anton-mir/airc-device/enclosure_drawings/readme.md

### Autocad AirC device enclosure drawings

Use AutoCad 2000 to open
