anton-mir/airc-device/docs/AirC sensors and pinout specification.ods

DESCRIPTION | Range and max value | SENSOR Note | INFO
CO, digital | 1000 ppm, 1163 mg | spec | https://www.spec-sensors.com/product/digital-co-sensor/
NO2, digital | 5 ppm, 10 mg | spec | https://www.spec-sensors.com/product/digital-gas-sensor-module-no2/
SO2, digital | 20 ppm, 53 mg | spec | https://www.spec-sensors.com/product/digital-gas-sensor-module-so2/
O3, digital | 5 ppm, 1 mg | spec | https://www.spec-sensors.com/product/digital-gas-sensor-ozone/
Dust sensor PM2.5 and PM10 | 1.0-2.5 um, 2.5-10 um | NOVA SDS011 | https://www-sd-nf.oss-cn-beijing.aliyuncs.com/%E5%AE%98%E7%BD%91%E4%B8%8B%E8%BD%BD/SDS011%20laser%20PM2.5%20sensor%20specification-V1.4.pdf
CCS811 Air Quality Sensor | eCO2 (equivalent CO2) 0-5000 ppm TVOC (Total Volatile Organic Compounds) 0-6000 ppb | CCS811, I2C address 0x5A | https://www.dfrobot.com/product-1981.html
Complex HCHO sensor - CH3, C6H6, H2CO | 1-50 ppm | DFRobot Gravity HCHO Sensor | https://wiki.dfrobot.com/Gravity__HCHO_Sensor_SKU__SEN0231#target_4
Weather module | Temp: -40 - 85 Celsius with accuracy 0.5-1 degree Humidity: 0 - 100% | BME280, SDO->GND I2C address is 0x76 | https://cdn-shop.adafruit.com/datasheets/BST-BME280_DS001-10.pdf
Commuter CD74HC4067 |  |  | http://www.ti.com/lit/ds/symlink/cd74hc4067.pdf
STM32F104 DISCOVERY | Connection name | Note | Pinout at GL Board (number of pins/pin id)
PA8 | Commuter EN - Enable/Disable pin | MCO | 1xC
PE6 | Commuter CD74HC4067 control pin S0 | TP3 | 3xA
PC13 | Commuter CD74HC4067 control pin S1 | TP4 | 3xA
PE5 | Commuter CD74HC4067 control pin S2 | TP6 | 3xA
PD6 | Commuter CD74HC4067 control pin S3 | TP7 | 3xB
PD8 | Commuter CD74HC4067 output pin SIG | UART input/output duplex mode: huart3.Init.Mode = UART_MODE_TX_RX; | 3xG
PB6 | I2C SCL CCS811 Air Quality Sensor, BME280 |  | DD
PB9 | I2C SDA CCS811 Air Quality Sensor, BME280 |  | DD
PD2 | G led | TP9 | 3xB
PB14 | B led | TP10 | 2xF
PD3 | R led | TP8 | 3xB
PB15 | REED SW | TP11 | 2xF
PC6 | Connected to TX of ESP01 |  | EE
PC7 | Connected to RX of ESP01 |  | EE
PE1 | ESP01 Reset pin |  | EE
PC2 | Fan 1 | TP2 | 1xH
PA3 | Fan 2 | TP5 | 1xI
PD7 | SPI for Starterkit Flash memory CS pin
PA5 | SPI SCK
PB5 | SPI MOSI
PB4 | SPI MISO
PB1 | ADC for analog temp sensor on GL starterkit board
Commuter CD74HC4067 output pin name | Sensor | Comment | Note
C0 | HCHO sensor input | connected to TX pin of HCHO sensor | Sends data periodically always
C1 | input from PM dust sensor | connected to TX pin of dust sensor | Sends data periodically after initial setup
C2 | SO2 spec sensor input | RX pin of spec sensor | get data from sensor
C3 | SO2 spec sensor output | TX pin of spec sensor | send to sensor
C4 | NO2 spec sensor input | RX pin of spec sensor | get data from sensor
C5 | NO2 spec sensor output | TX pin of spec sensor | send to sensor
C6 | CO spec sensor input | RX pin of spec sensor | get data from sensor
C7 | CO spec sensor output | TX pin of spec sensor | send to sensor
C8 | O3 spec sensor input | RX pin of spec sensor | get data from sensor
C9 | O3 spec sensor output | TX pin of spec sensor | send to sensor
C10 | output commands to PM dust sensor | connected to RX pin of dust sensor | TODO: add code for sending commands
