anton-mir/airc-device/pcb/3D View SIde A.png

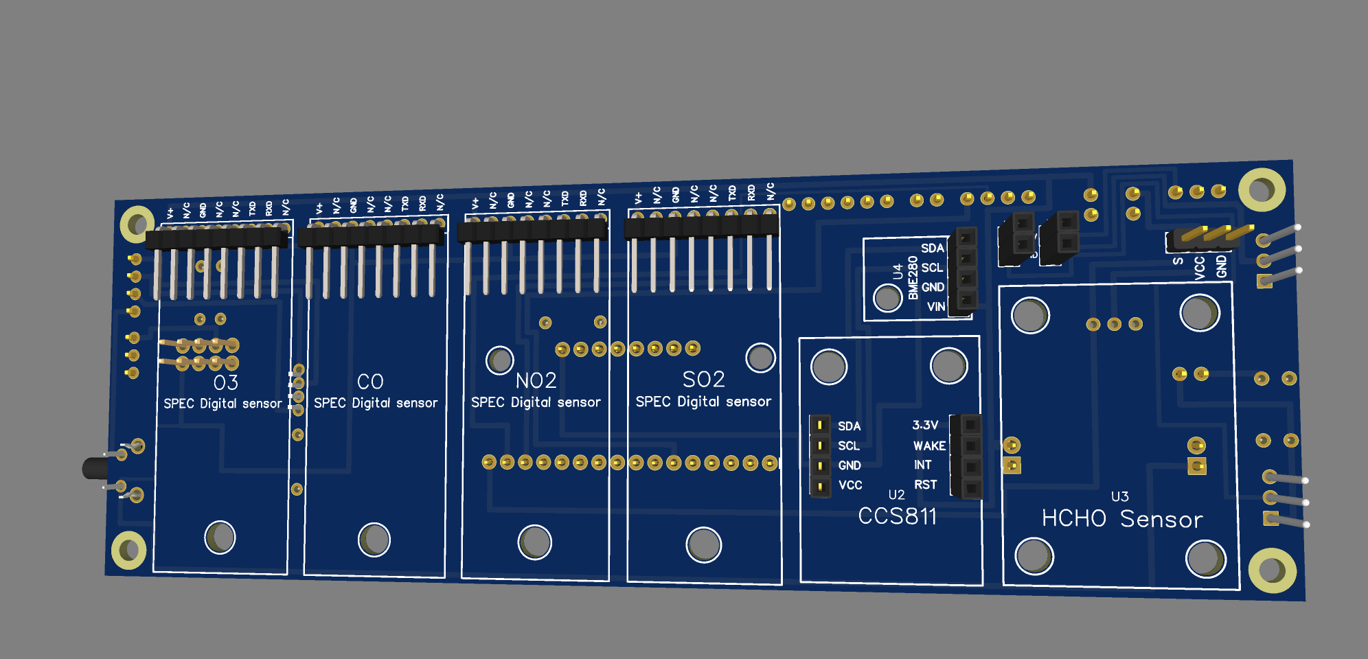
pcb/3D View SIde A.png
