anton-mir/airc-device/pcb/3D View Side B.png

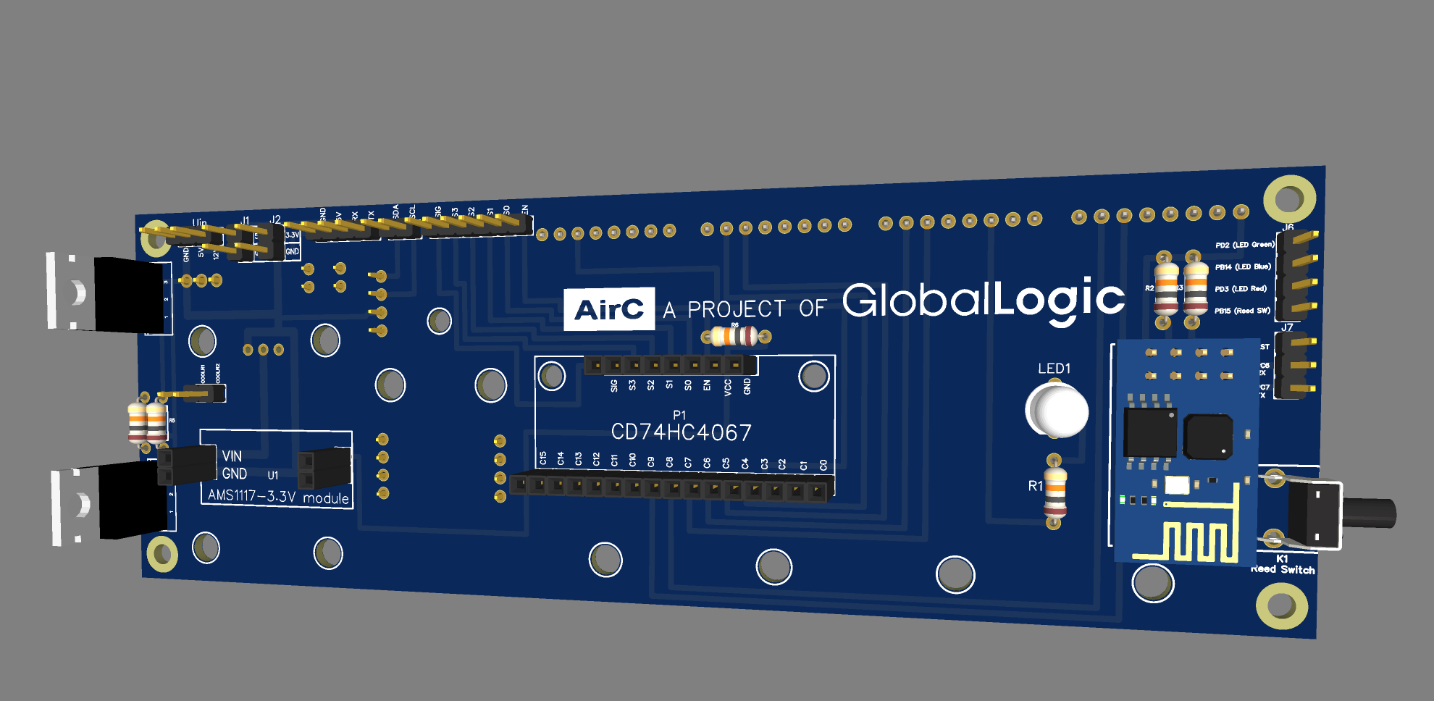
pcb/3D View Side B.png
