anton-mir/airc-device/pcb/Side A.png

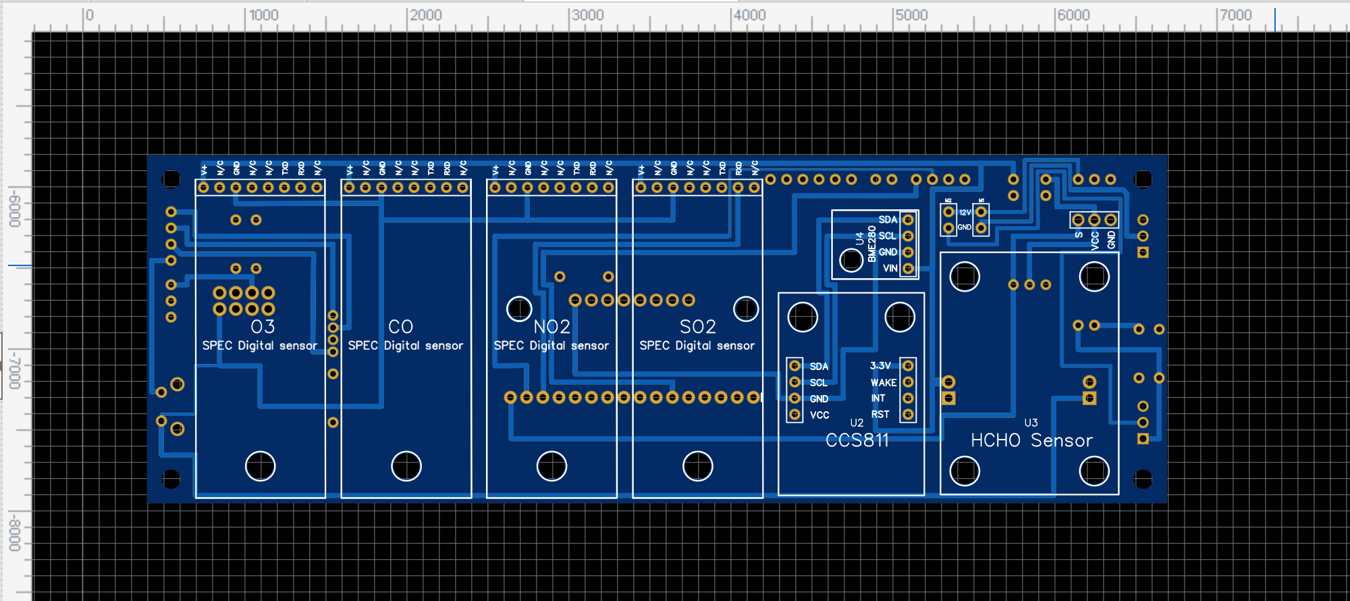
pcb/Side A.png
