anton-mir/airc-device/pcb/Side B.png

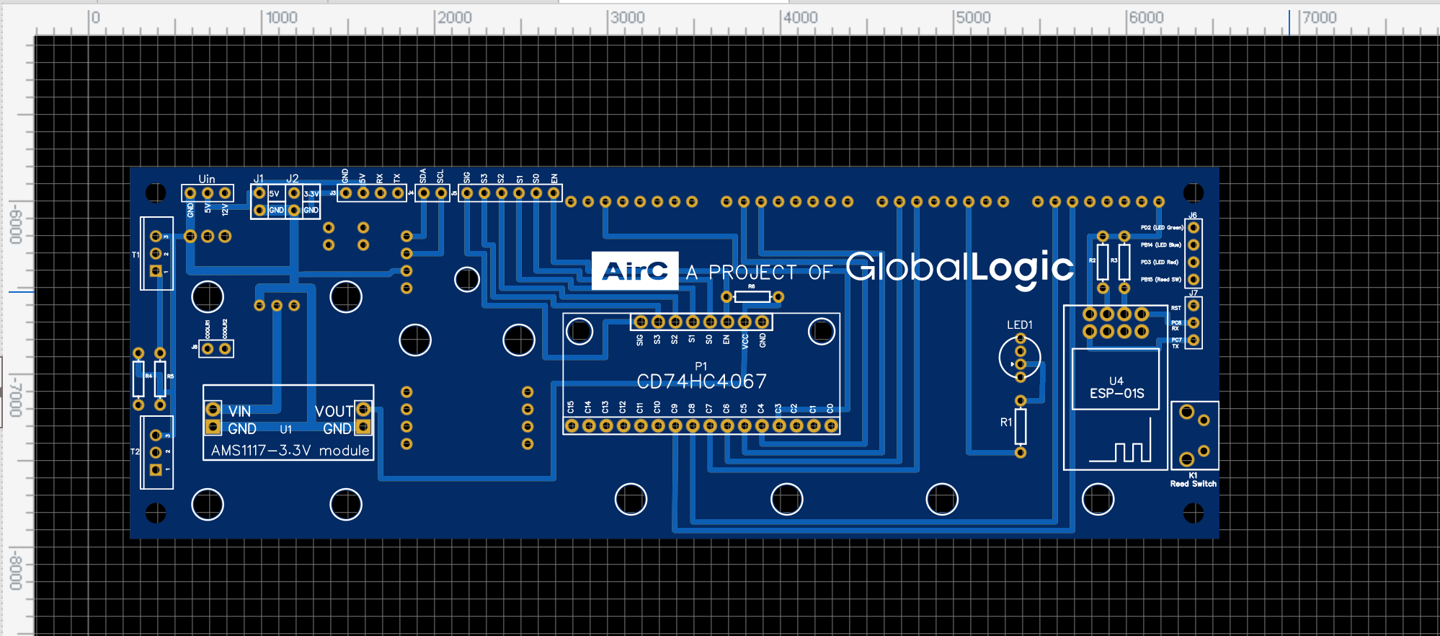
pcb/Side B.png
