anton-mir/airc-device/docs/SEN0231 HCHO Sensor Schematic.pdf

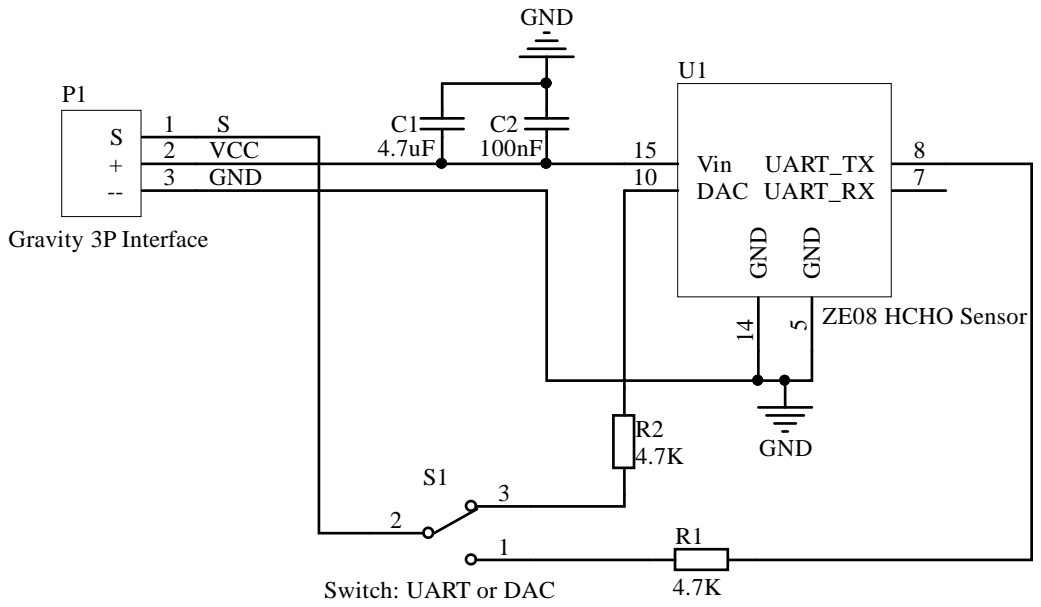
[picture p5: page 1]

Switch: UART or DAC

HCHO Sensor Title: | SKU: SEN0231
Drawn: roker-CD | Revision: V1.0 | Size: A4

Date: 2016/12/9 | Time: 18:14:12
