anton-mir/airc-device/pcb/Schematic.pdf

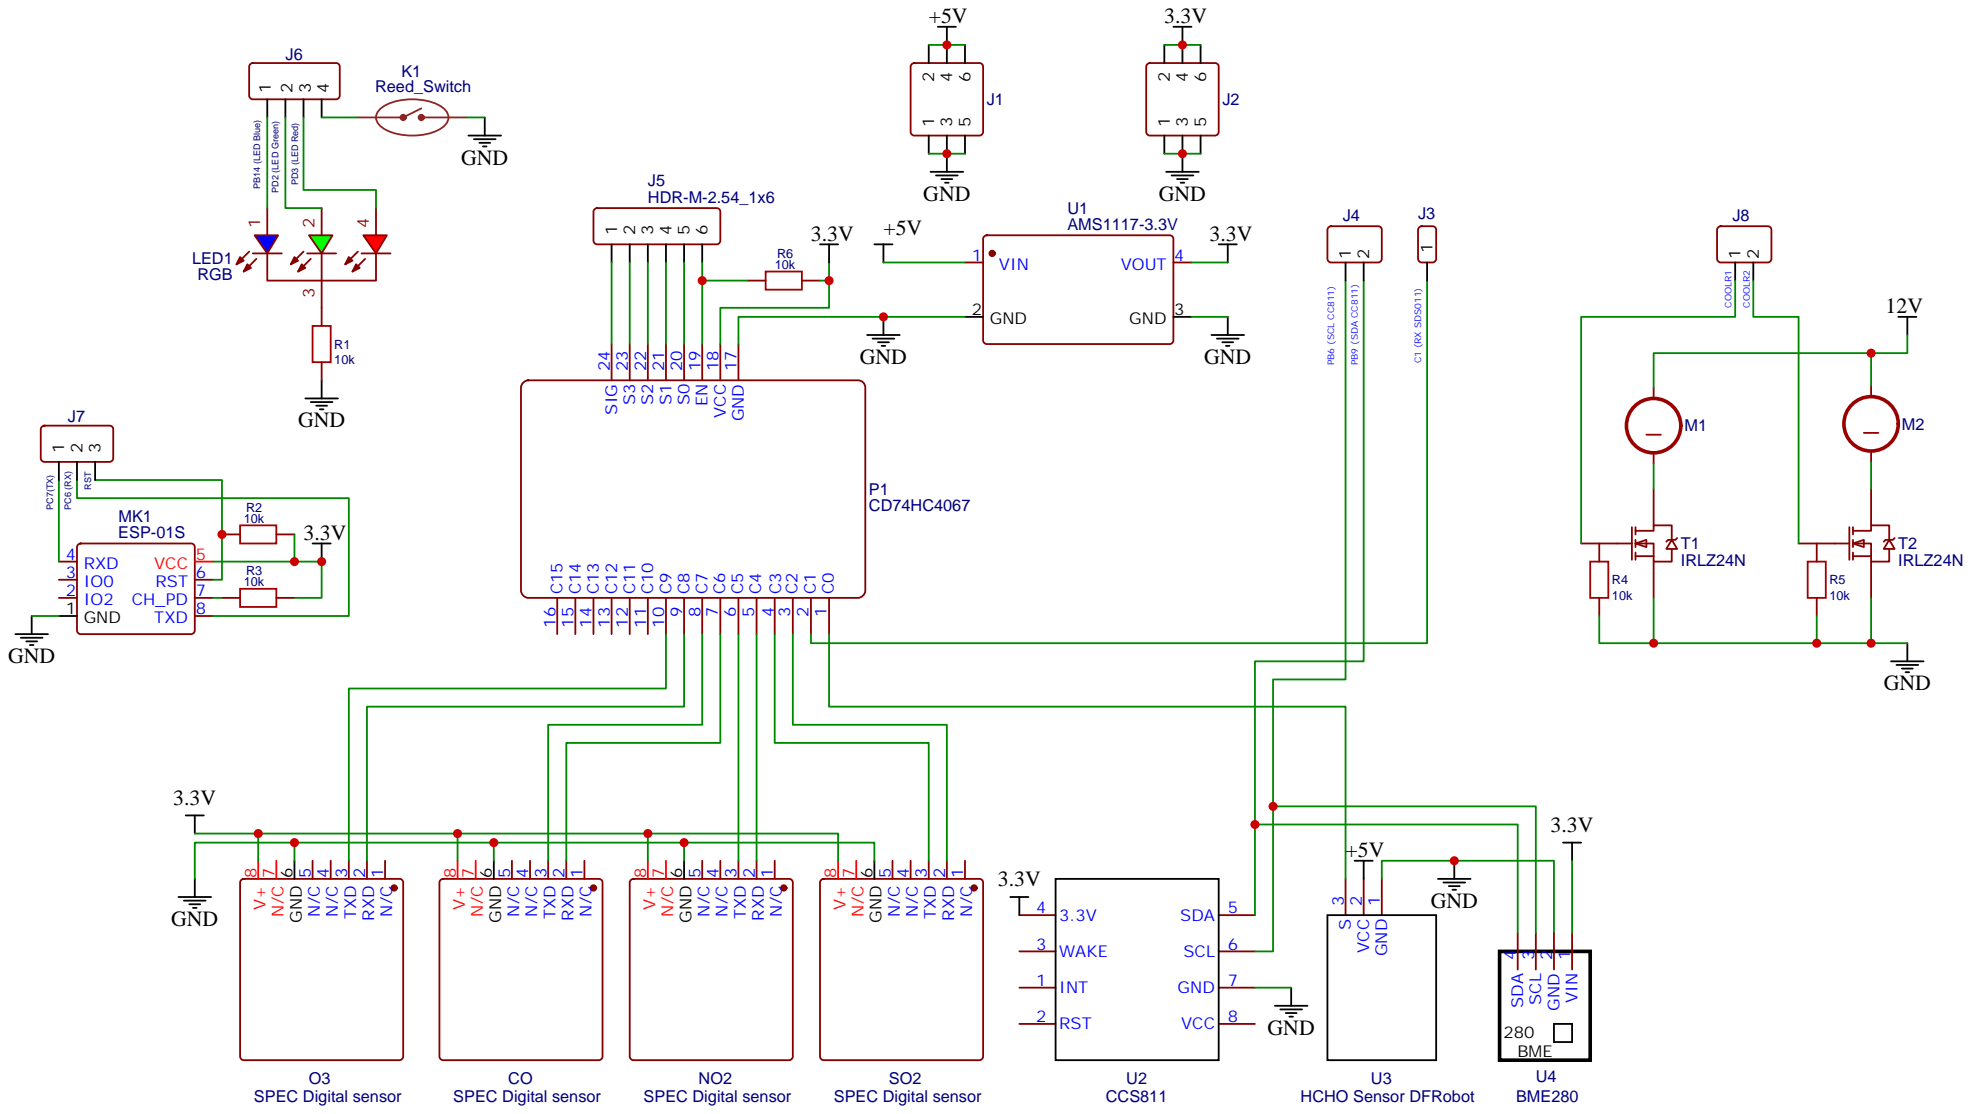
[picture p6: page 1]

GND 17 VCC 18 EN 19 S0 20 S1 21 S2 22 S3 23 SIG 24
