anton-mir/airc-device/pcb/Side A-B.pdf

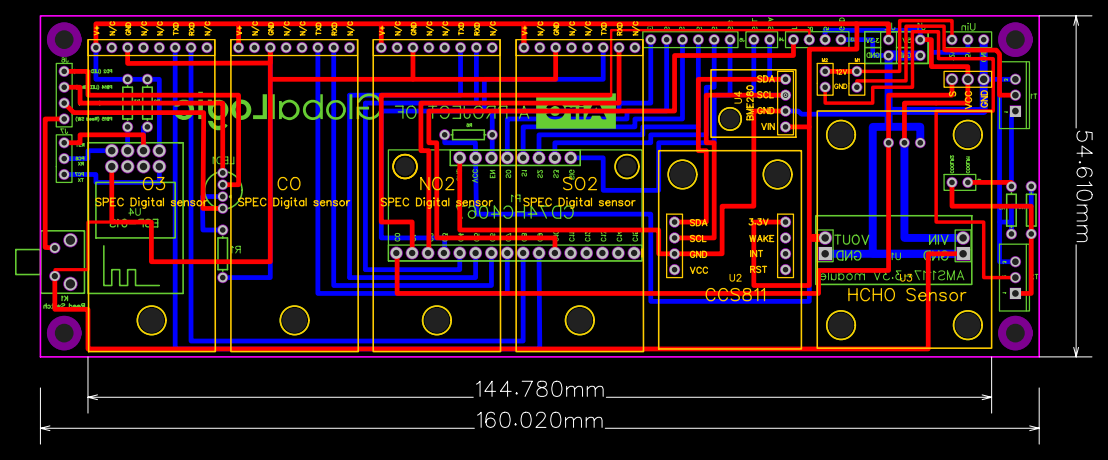
[picture p7: page 1]
