anton-mir/airc-device/pcb/Side A.pdf

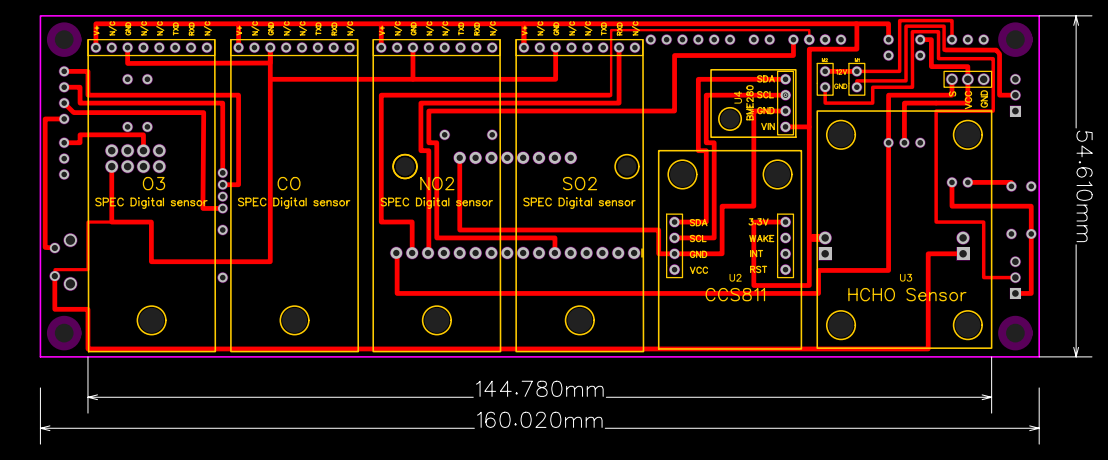
[picture p8: page 1]
