anton-mir/airc-device/pcb/Side B.pdf

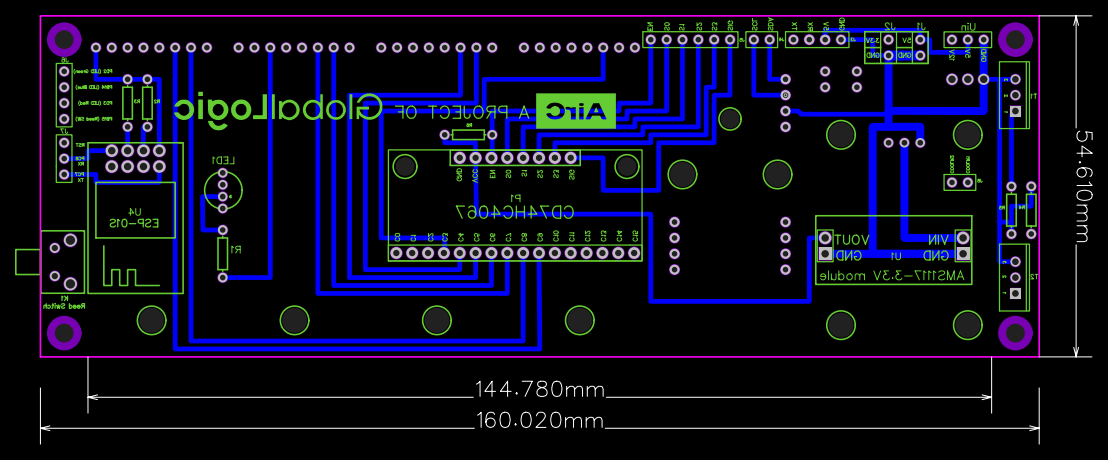
[picture p9: page 1]
