anton-mir/airc-device/src/main.c

/**
  ******************************************************************************
  * @file    Templates/Src/main.c
  * @author  MCD Application Team
  * @brief   Main program body
  ******************************************************************************
  * @attention
  *
  * <h2><center>&copy; COPYRIGHT(c) 2017 STMicroelectronics</center></h2>
  *
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
  ******************************************************************************
  */

/* Includes ------------------------------------------------------------------*/
#include "main.h"
#include "lwip/init.h"
#include "lwip/netif.h"
#include "lwip/timeouts.h"
#include "lwip/inet.h"
#include "lwip/tcpip.h"
#include "netif/etharp.h"
#include "ethernetif.h"
#include "uart_sensors.h"
#include "esp8266_wifi.h"
#include "http_helper.h"
#include "ksz8081rnd.h"
#include "wh1602.h"
#include "FreeRTOS.h"
#include "FreeRTOSConfig.h"
#include "task.h"
#include "tasks_def.h"
#include "hw_delay.h"
#include "lm335z.h"
#include "eth_server.h"
#include "eth_sender.h"
#include "queue.h"
#include "i2c_ccs811sensor.h"
#include "data_collector.h"
#include "leds.h"
#include "flash_SST25VF016B.h"
#include "config_board.h"
#include"fans.h"
#include "display_data.h"
#include "bmp280.h"

volatile boxConfig_S device_config = { 0 };

TaskHandle_t init_handle = NULL;
TaskHandle_t ethif_in_handle = NULL;
TaskHandle_t link_state_handle = NULL;
TaskHandle_t dhcp_fsm_handle = NULL;
TaskHandle_t wifi_tsk_handle = NULL;
TaskHandle_t esp_rx_tsk_handle = NULL;
TaskHandle_t analog_temp_handle = NULL;
TaskHandle_t eth_server_handle = NULL;
TaskHandle_t i2c_ccs811sensor_handle = NULL;
TaskHandle_t eth_sender_handle = NULL;
TaskHandle_t data_collector_handle = NULL;
TaskHandle_t reed_switch_handle = NULL;
TaskHandle_t uart_sensors_handle = NULL;
TaskHandle_t display_data_task_handle = NULL;
TaskHandle_t i2c_bme280_sensor_handle = NULL;

EventGroupHandle_t eg_task_started = NULL;

static RNG_HandleTypeDef rng_handle;

struct netif gnetif;

static void SystemClock_Config(void);
void Error_Handler(void);
static void netif_setup();
void init_task(void *arg);

uint32_t rand_wrapper()
{
    uint32_t random = 0;
    (void)HAL_RNG_GenerateRandomNumber(&rng_handle, &random);

    return random;
}

void init_task(void *arg)
{
    GPIO_InitTypeDef gpio;
    BaseType_t status;
    struct netif *netif = (struct netif *)arg;

    __HAL_RCC_GPIOD_CLK_ENABLE();
    __HAL_RCC_GPIOC_CLK_ENABLE();
    __HAL_RCC_USART6_CLK_ENABLE();
    __HAL_RCC_DMA2_CLK_ENABLE();

    (void)HAL_RNG_Init(&rng_handle);

    eg_task_started = xEventGroupCreate();
    configASSERT(eg_task_started);

    xEventGroupSetBits(eg_task_started, EG_INIT_STARTED);
    initBlueButtonAndReedSwitch();
    initLeds();
    init_fans();

    /* Initialize LCD */
    lcd_init();
    lcd_clear();
    lcd_print_string("Init...");

    // Init ESP8266
    ESP_InitPins();
    ESP_InitUART();
    ESP_InitDMA();

    //Init Flash_SPI
    Flash_Init();

    /* Create TCP/IP stack thread */
    tcpip_init(NULL, NULL);

    /* Initialize PHY */
    netif_setup();
    status = xTaskCreate(
            link_state,
            "link_st",
            LINK_STATE_TASK_STACK_SIZE,
            (void *) netif,
            LINK_STATE_TASK_PRIO,
            &link_state_handle);

    configASSERT(status);

    status = xTaskCreate(
            dhcp_fsm,
            "dhcp_fsm",
            DHCP_FSM_TASK_STACK_SIZE,
            (void *) netif,
            DHCP_FSM_TASK_PRIO,
            &dhcp_fsm_handle);

    configASSERT(status);

    status = xTaskCreate(
            ethernetif_input,
            "ethif_in",
            ETHIF_IN_TASK_STACK_SIZE,
            (void *) netif,
            ETHIF_IN_TASK_PRIO,
            &ethif_in_handle);

    configASSERT(status);

    status = xTaskCreate(
            uart_sensors,
            "uart_sensors",
            UART_SENSORS_TASK_STACK_SIZE,
            (void *)netif,
            UART_SENSORS_TASK_PRIO,
            &uart_sensors_handle);

    configASSERT(status);

    status = xTaskCreate(
            bme280_sensor,
            "i2c_bme280_sensor",
            I2C_BME280_SENSOR_TASK_STACK_SIZE,
            (void *)netif,
            I2C_BME280_SENSOR_TASK_PRIO,
            &i2c_bme280_sensor_handle);

    configASSERT(status);

    status = xTaskCreate(
            eth_server,
            "eth_server",
            ETH_SERVER_TASK_STACK_SIZE,
            NULL,
            ETH_SERVER_TASK_PRIO,
            &eth_server_handle);

    configASSERT(status);

    status = xTaskCreate(
	     i2c_ccs811sensor,
 	     "i2c_ccs811sensor",
             ETH_SERVER_TASK_STACK_SIZE,
             NULL,
             ETH_SERVER_TASK_PRIO,
             &i2c_ccs811sensor_handle);

    configASSERT(status);

    status = xTaskCreate(
                esp_rx_task,
                "esp_rx_tsk",
                ESP8266_RX_TASK_STACK_SIZE,
                NULL,
                ESP8266_RX_TASK_PRIO,
                &esp_rx_tsk_handle);

    configASSERT(status);

    status = xTaskCreate(
                wifi_task,
                "wifi_tsk",
                ESP8266_WIFI_TASK_STACK_SIZE,
                NULL,
                ESP8266_WIFI_TASK_PRIO,
                &wifi_tsk_handle);

    configASSERT(status);

    status = xTaskCreate(
            analog_temp,
            "analog_temp",
            ANALOG_TEMP_TASK_STACK_SIZE,
            NULL,
            ANALOG_TEMP_TASK_PRIO,
            &analog_temp_handle);

    configASSERT(status);

    status = xTaskCreate(
            data_collector,
            "data_collector",
            DATA_COLLECTOR_STACK_SIZE,
            NULL,
            DATA_COLLECTOR_PRIO,
            &data_collector_handle);
    configASSERT(status);

    status = xTaskCreate(
            eth_sender,
            "eth_sender",
            ETH_SENDER_TASK_STACK_SIZE,
            NULL,
            ETHIF_IN_TASK_PRIO,
            &eth_sender_handle);

    configASSERT(status);

    status = xTaskCreate(
            reed_switch_task,
            "reed_switch_task",
            REED_SWITCH_STACK_SIZE,
            NULL,
            REED_SWITCH_PRIO,
            &reed_switch_handle);
    configASSERT(status);
    status = xTaskCreate(
        display_data_task,
        "displya_data_task",
        DISPLAY_DATA_TASK_STACK_SIZE,
        NULL,
        DISPLAY_DATA_TASK_PRIO,
        &display_data_task_handle);
    configASSERT(status);

    /* Wait for all tasks initialization */
    xEventGroupWaitBits(
            eg_task_started,
            (EG_INIT_STARTED | EG_ETHERIF_IN_STARTED | EG_LINK_STATE_STARTED |
             EG_DHCP_FSM_STARTED | EG_UART_SENSORS_STARTED | EG_WIFI_TSK_STARTED |
             EG_ESP_RX_TSK_STARTED | EG_ANALOG_TEMP_STARTED | EG_ETH_SENDER_STARTED |
             EG_ETH_SERVER_STARTED | EG_DATA_COLLECTOR_STARTED| EG_REED_SWITCH_STARTED |
             EG_I2C_BME280_STARTED | EG_I2C_CCS811_STARTED),
            pdFALSE,
            pdTRUE,
            portMAX_DELAY);

    if (netif_is_up(netif)) {
        /* Start DHCP address request */
        ethernetif_dhcp_start();
    }


    gpio.Mode = GPIO_MODE_OUTPUT_PP;
    gpio.Pull = GPIO_NOPULL;
    gpio.Pin = GPIO_PIN_13;
    HAL_GPIO_Init(GPIOD, &gpio);
    HAL_GPIO_WritePin(GPIOD, GPIO_PIN_13, GPIO_PIN_SET);

    // Multiplexer on/off pin - init to off state (pull-up)
    gpio.Mode = GPIO_MODE_OUTPUT_PP;
    gpio.Pull = GPIO_PULLUP;
    gpio.Pin = GPIO_PIN_8;
    HAL_GPIO_Init(GPIOA, &gpio);
    HAL_GPIO_WritePin(GPIOA, GPIO_PIN_8, GPIO_PIN_SET);

    for (;;) {

        uint16_t current_pin = choose_pin(current_mode);
        static uint8_t leds_turned_off = 0;

//        if (!netif_is_link_up(netif)) {
//            lcd_clear();
//            lcd_print_string_at("Link:", 0, 0);
//            lcd_print_string_at("down", 0, 1);
//        }

        if (current_pin == OFF_LEDS)
        {
            if (!leds_turned_off) // Don't reset leds if they are already reset
            {
                HAL_GPIO_WritePin(GPIOD,RED_LED |GREEN_LED,GPIO_PIN_RESET);
                HAL_GPIO_WritePin(GPIOB,BLUE_LED,GPIO_PIN_RESET);
                leds_turned_off = 1;
            }
        }
        else
        {
            leds_turned_off = 0;
            TickType_t delay = (current_pin == RED_LED) ? 500u : 1500u;
            if (current_pin == BLUE_LED)
            {
                HAL_GPIO_TogglePin(GPIOB,current_pin);
            }
            else
            {
                HAL_GPIO_TogglePin(GPIOD,current_pin);
            }
            vTaskDelay(delay);
        }
    }
}
/* Private functions ---------------------------------------------------------*/
/**
  * @brief  Main program
  * @param  None
  * @retval None
  */
int main(void)
{
    BaseType_t status;

    HAL_Init();

    /* Configure the system clock to 168 MHz */
    SystemClock_Config();

    status = xTaskCreate(
                    init_task,
                    "init",
                    INIT_TASK_STACK_SIZE,
                    (void *)&gnetif,
                    INIT_TASK_PRIO,
                    &init_handle);

    configASSERT(status);

    vTaskStartScheduler();

    for (;;) { ; }
}

void HAL_MspInit(void)
{
    __HAL_RCC_SYSCFG_CLK_ENABLE();
    __HAL_RCC_PWR_CLK_ENABLE();
}

uint32_t HAL_GetTick(void)
{
    return xTaskGetTickCount();
}

void HAL_I2C_MspInit(I2C_HandleTypeDef* hi2c)
{
    GPIO_InitTypeDef GPIO_InitStruct = {0};
    if (hi2c->Instance == I2C1) {
        __HAL_RCC_GPIOB_CLK_ENABLE();

        /**I2C1 GPIO Configuration
        PB6     ------> I2C1_SCL
        PB9     ------> I2C1_SDA
        */
        GPIO_InitStruct.Pin = GPIO_PIN_6 | GPIO_PIN_9;
        GPIO_InitStruct.Mode = GPIO_MODE_AF_OD;
        GPIO_InitStruct.Pull = GPIO_PULLUP;
        GPIO_InitStruct.Speed = GPIO_SPEED_FREQ_VERY_HIGH;
        GPIO_InitStruct.Alternate = GPIO_AF4_I2C1;
        HAL_GPIO_Init(GPIOB, &GPIO_InitStruct);

        __HAL_RCC_I2C1_CLK_ENABLE();
    }
}

/**
  * @brief  System Clock Configuration
  *         The system Clock is configured as follow :
  *            System Clock source            = PLL (HSE)
  *            SYSCLK(Hz)                     = 168000000
  *            HCLK(Hz)                       = 168000000
  *            AHB Prescaler                  = 1
  *            APB1 Prescaler                 = 4
  *            APB2 Prescaler                 = 2
  *            HSE Frequency(Hz)              = 8000000
  *            PLL_M                          = 8
  *            PLL_N                          = 336
  *            PLL_P                          = 2
  *            PLL_Q                          = 7
  *            VDD(V)                         = 3.3
  *            Main regulator output voltage  = Scale1 mode
  *            Flash Latency(WS)              = 5
  * @param  None
  * @retval None
  */
static void SystemClock_Config(void)
{
    RCC_ClkInitTypeDef RCC_ClkInitStruct;
    RCC_OscInitTypeDef RCC_OscInitStruct;

    /* Enable Power Control clock */
    __HAL_RCC_PWR_CLK_ENABLE();

    /* The voltage scaling allows optimizing the power consumption when the device is
        clocked below the maximum system frequency, to update the voltage scaling value
        regarding system frequency refer to product datasheet.  */
    __HAL_PWR_VOLTAGESCALING_CONFIG(PWR_REGULATOR_VOLTAGE_SCALE1);

    /* Enable HSE Oscillator and activate PLL with HSE as source */
    RCC_OscInitStruct.OscillatorType = RCC_OSCILLATORTYPE_HSE;
    RCC_OscInitStruct.HSEState = RCC_HSE_ON;
    RCC_OscInitStruct.PLL.PLLState = RCC_PLL_ON;
    RCC_OscInitStruct.PLL.PLLSource = RCC_PLLSOURCE_HSE;
    RCC_OscInitStruct.PLL.PLLM = 8;
    RCC_OscInitStruct.PLL.PLLN = 336;
    RCC_OscInitStruct.PLL.PLLP = RCC_PLLP_DIV2;
    RCC_OscInitStruct.PLL.PLLQ = 7;
    if(HAL_RCC_OscConfig(&RCC_OscInitStruct) != HAL_OK)
    {
        /* Initialization Error */
        Error_Handler();
    }

    /* Select PLL as system clock source and configure the HCLK, PCLK1 and PCLK2
        clocks dividers */
    RCC_ClkInitStruct.ClockType = (RCC_CLOCKTYPE_SYSCLK | RCC_CLOCKTYPE_HCLK | RCC_CLOCKTYPE_PCLK1 | RCC_CLOCKTYPE_PCLK2);
    RCC_ClkInitStruct.SYSCLKSource = RCC_SYSCLKSOURCE_PLLCLK;
    RCC_ClkInitStruct.AHBCLKDivider = RCC_SYSCLK_DIV1;
    RCC_ClkInitStruct.APB1CLKDivider = RCC_HCLK_DIV4;
    RCC_ClkInitStruct.APB2CLKDivider = RCC_HCLK_DIV2;
    if(HAL_RCC_ClockConfig(&RCC_ClkInitStruct, FLASH_LATENCY_5) != HAL_OK)
    {
        /* Initialization Error */
        Error_Handler();
    }

    /* STM32F405x/407x/415x/417x Revision Z devices: prefetch is supported  */
    if (HAL_GetREVID() == 0x1001)
    {
        /* Enable the Flash prefetch */
        __HAL_FLASH_PREFETCH_BUFFER_ENABLE();
    }
}

/**
  * @brief EXTI line detection callbacks
  * @param  pin: Specifies the pins connected EXTI line
  * @retval None
  */

void HAL_GPIO_EXTI_Callback(uint16_t pin)
{
    if (pin == BLUE_BUTTON_DISCOVERY)
    {
        HAL_GPIO_TogglePin(GPIOD, RED_LED_DISCOVERY);
    }
    else if (pin == RMII_PHY_INT_PIN)
    {
        /* Get the IT status register value */
        ethernetif_phy_irq();
    }
}

static void netif_setup()
{
    ip_addr_t ipaddr;
    ip_addr_t netmask;
    ip_addr_t gw;

    ip_addr_set_zero_ip4(&ipaddr);
    ip_addr_set_zero_ip4(&netmask);
    ip_addr_set_zero_ip4(&gw);

    /* Add the network interface */
    netif_add(&gnetif, &ipaddr, &netmask, &gw, NULL, &ethernetif_init, &ethernet_input);

    /* Registers the default network interface */
    netif_set_default(&gnetif);

    /* Set the link callback function, this function is called on change of link status */
    netif_set_link_callback(&gnetif, ethernetif_link_update);

    if (netif_is_link_up(&gnetif))
    {
        /* When the netif is fully configured this function must be called */
        netif_set_up(&gnetif);
    }
    else
    {
        /* When the netif link is down this function must be called */
        netif_set_down(&gnetif);
    }
}

/**
  * @brief  This function is executed in case of error occurrence.
  * @param  None
  * @retval None
  */
void Error_Handler(void)
{
    lcd_clear();
    lcd_print_string("Er@Error_Handler");
    HAL_Delay(1000);
    /* User may add here some code to deal with this error */
    while(1)
    {
    }
}

void EXTI0_IRQHandler(void){
    HAL_GPIO_EXTI_IRQHandler(BLUE_BUTTON_DISCOVERY);
}



void initLeds()
{
    __HAL_RCC_GPIOD_CLK_ENABLE();
    GPIO_InitTypeDef gpio;
    gpio.Mode = GPIO_MODE_OUTPUT_PP;
    gpio.Pull = GPIO_PULLUP;

    gpio.Pin = RED_LED | GREEN_LED;
    HAL_GPIO_Init(GPIOD, &gpio);
    HAL_GPIO_WritePin(GPIOD,RED_LED |GREEN_LED,GPIO_PIN_RESET);

    gpio.Pin = BLUE_LED;
    HAL_GPIO_Init(GPIOB, &gpio);
    HAL_GPIO_WritePin(GPIOB,BLUE_LED,GPIO_PIN_RESET);

    gpio.Pin = RED_LED_DISCOVERY;
    HAL_GPIO_Init(GPIOD, &gpio);
    HAL_GPIO_WritePin(GPIOD,RED_LED_DISCOVERY,GPIO_PIN_RESET);
}

/************************ (C) COPYRIGHT STMicroelectronics *****END OF FILE****/
