anton-mir/airc-device/src/uart_sensors.c

#include "uart_sensors.h"

#include <stdint.h>
#include <stdlib.h>
#include <ctype.h>
#include "FreeRTOS.h"
#include "task.h"
#include "main.h"
#include "string.h"
#include "semphr.h"

#define NOTIFY_CLEAR_VAL    (0xFFFFFFFF)
#define HAL_DEFAULT_TIMEOUT (500)
/* 5ms will be enough to send 1 byte */
#define WAKEUP_TIMEOUT      (5)
#define DATA_REQ_TIMEOUT    (5)

#define UART_DISABLE_RXTX(__HANDLE__)        \
  do{                                                       \
    CLEAR_BIT((__HANDLE__)->Instance->CR1, (USART_CR1_RE | USART_CR1_TE)); \
  } while(0U)

struct dma_base_reg {
  __IO uint32_t ISR;   /*!< DMA interrupt status register */
  __IO uint32_t Reserved0;
  __IO uint32_t IFCR;  /*!< DMA interrupt flag clear register */
};

uint8_t spec_wake = '\n';
uint8_t spec_get_data = '\r';
uint8_t spec_reset = 'r';
uint8_t spec_sleep = 's';
uint8_t spec_continuous = 'c';

SemaphoreHandle_t HCHO_mutex = NULL;
SemaphoreHandle_t PMS_mutex = NULL;
SemaphoreHandle_t SPEC_mutex = NULL;

xTimerHandle timer_SPEC_ISR;

volatile char uart3IncomingDataBuffer[MAX_SPEC_BUF_LEN];
double pm2_5_val = 0;
double pm10_val = 0;
double HCHO_val = 0;

struct SPEC_values SPEC_SO2_values, SPEC_NO2_values, SPEC_CO_values, SPEC_O3_values;

const long long int SPEC_SO2_SN = 102219020326;
const long long int SPEC_NO2_SN = 31120010317;
const long long int SPEC_CO_SN = 60619020451;
const long long int SPEC_O3_SN = 22620010208;

typedef enum{
    SPEC_T_SO2,
    SPEC_T_NO2,
    SPEC_T_CO,
    SPEC_T_O3
}SPEC_TYPES;

typedef enum{
    HCHO_T,
    PM10_T,
    PM2_5_T,
}PM_HCHO_TYPES;

static HAL_StatusTypeDef uart_spec_wakeup(uint8_t chan);
static HAL_StatusTypeDef uart_spec_get_data(uint8_t tx, uint8_t rx,
                                            uint32_t *rx_len);
static HAL_StatusTypeDef uart_enable_tx(uint8_t chan);
static HAL_StatusTypeDef uart_enable_rx(uint8_t chan, uint8_t *buf,
                                        uint32_t buf_len);
static HAL_StatusTypeDef uart_send_data(uint8_t *data, uint32_t len,
                                        uint32_t timeout);
static uint32_t uart_wait_response(uint32_t timeout);
static HAL_StatusTypeDef uart_release();
static HAL_StatusTypeDef uart_enable_dma_rx(UART_HandleTypeDef *huart,
                                            uint8_t *data, uint16_t size);
static HAL_StatusTypeDef uart_disable_dma_rx(UART_HandleTypeDef *huart);
static void uart_end_rx_transfer(UART_HandleTypeDef *huart);

static void USART3_UART_Init(void)
{
    huart3.Instance = USART3;
    huart3.Init.BaudRate = 9600;
    huart3.Init.WordLength = UART_WORDLENGTH_8B;
    huart3.Init.StopBits = UART_STOPBITS_1;
    huart3.Init.Parity = UART_PARITY_NONE;
    huart3.Init.Mode = UART_MODE_TX_RX;
    huart3.Init.HwFlowCtl = UART_HWCONTROL_NONE;
    huart3.Init.OverSampling = UART_OVERSAMPLING_16;
    if (HAL_HalfDuplex_Init(&huart3) != HAL_OK){}
}

static HAL_StatusTypeDef USART3_DMA_Init(void)
{
    huart3_dma_rx.Instance = DMA1_Stream1;
    huart3_dma_rx.Init.Channel = DMA_CHANNEL_4;
    huart3_dma_rx.Init.Direction = DMA_PERIPH_TO_MEMORY;
    huart3_dma_rx.Init.PeriphInc = DMA_PINC_DISABLE;
    huart3_dma_rx.Init.MemInc = DMA_MINC_ENABLE;
    huart3_dma_rx.Init.Mode = DMA_NORMAL;
    huart3_dma_rx.Init.Priority = DMA_PRIORITY_VERY_HIGH;
    huart3_dma_rx.Init.PeriphDataAlignment = DMA_PDATAALIGN_BYTE;
    huart3_dma_rx.Init.MemDataAlignment = DMA_MDATAALIGN_BYTE;
    huart3_dma_rx.Init.FIFOMode = DMA_FIFOMODE_DISABLE;

    if (HAL_DMA_Init(&huart3_dma_rx) == HAL_ERROR) return HAL_ERROR;
    __HAL_LINKDMA(&huart3, hdmarx, huart3_dma_rx);

    return HAL_OK;
}

static void GPIO_Init(void) {
    GPIO_InitTypeDef GPIO_InitStruct = {0};

    __HAL_RCC_GPIOC_CLK_ENABLE();
    __HAL_RCC_GPIOE_CLK_ENABLE();
    __HAL_RCC_GPIOB_CLK_ENABLE();
    __HAL_RCC_GPIOD_CLK_ENABLE();

    HAL_GPIO_WritePin(GPIOC, GPIO_PIN_13, GPIO_PIN_RESET);
    HAL_GPIO_WritePin(GPIOE, GPIO_PIN_5|GPIO_PIN_6, GPIO_PIN_RESET);
    HAL_GPIO_WritePin(GPIOB, GPIO_PIN_6|GPIO_PIN_9, GPIO_PIN_RESET);
    HAL_GPIO_WritePin(GPIOD, GPIO_PIN_6|GPIO_PIN_8, GPIO_PIN_RESET);

    GPIO_InitStruct.Pin = GPIO_PIN_13;
    GPIO_InitStruct.Mode = GPIO_MODE_OUTPUT_PP;
    GPIO_InitStruct.Pull = GPIO_NOPULL;
    GPIO_InitStruct.Speed = GPIO_SPEED_FREQ_LOW;
    HAL_GPIO_Init(GPIOC, &GPIO_InitStruct);

    GPIO_InitStruct.Pin = GPIO_PIN_5|GPIO_PIN_6;
    GPIO_InitStruct.Mode = GPIO_MODE_OUTPUT_PP;
    GPIO_InitStruct.Pull = GPIO_NOPULL;
    GPIO_InitStruct.Speed = GPIO_SPEED_FREQ_LOW;
    HAL_GPIO_Init(GPIOE, &GPIO_InitStruct);

    GPIO_InitStruct.Pin = GPIO_PIN_6|GPIO_PIN_9;
    GPIO_InitStruct.Mode = GPIO_MODE_OUTPUT_PP;
    GPIO_InitStruct.Pull = GPIO_NOPULL;
    GPIO_InitStruct.Speed = GPIO_SPEED_FREQ_LOW;
    HAL_GPIO_Init(GPIOB, &GPIO_InitStruct);

    GPIO_InitStruct.Pin = GPIO_PIN_6;
    GPIO_InitStruct.Mode = GPIO_MODE_OUTPUT_PP;
    GPIO_InitStruct.Pull = GPIO_NOPULL;
    GPIO_InitStruct.Speed = GPIO_SPEED_FREQ_LOW;
    HAL_GPIO_Init(GPIOD, &GPIO_InitStruct);

}

static uint8_t chan_table[16][4] = {
        // s0, s1, s2, s3     channel
        {0,  0,  0,  0}, // 0 HCHO sensor RX
        {1,  0,  0,  0}, // 1 PM dust sensor RX
        {0,  1,  0,  0}, // 2 SO2 spec sensor TX
        {1,  1,  0,  0}, // 3 SO2 spec sensor RX
        {0,  0,  1,  0}, // 4 NO2 spec sensor TX
        {1,  0,  1,  0}, // 5 NO2 spec sensor RX
        {0,  1,  1,  0}, // 6 CO spec sensor  TX
        {1,  1,  1,  0}, // 7 CO spec sensor  RX
        {0,  0,  0,  1}, // 8 O3 spec sensor  TX
        {1,  0,  0,  1}, // 9 O3 spec sensor  RX
        {0,  1,  0,  1}, // 10
        {1,  1,  0,  1}, // 11
        {0,  0,  1,  1}, // 12
        {1,  0,  1,  1}, // 13
        {0,  1,  1,  1}, // 14
        {1,  1,  1,  1}  // 15
};

static void activate_multiplexer_channel(uint8_t channel){
    HAL_GPIO_WritePin(GPIOE, GPIO_PIN_6, chan_table[channel][0]);
    HAL_GPIO_WritePin(GPIOC, GPIO_PIN_13, chan_table[channel][1]);
    HAL_GPIO_WritePin(GPIOE, GPIO_PIN_5, chan_table[channel][2]);
    HAL_GPIO_WritePin(GPIOD, GPIO_PIN_6, chan_table[channel][3]);
}

static void get_spec_values(dataPacket_S *spec_struct, SemaphoreHandle_t mutex)
{
	if((mutex != NULL) && (xSemaphoreTake(mutex,portMAX_DELAY) == pdTRUE))
	{
        spec_struct->so2 = (double)SPEC_SO2_values.specPPB;
        spec_struct->so2_temp = (double)SPEC_SO2_values.specTemp;
        spec_struct->so2_hum = (double)SPEC_SO2_values.specRH;
        spec_struct->so2_err = (double)SPEC_SO2_values.error_reason;

        spec_struct->no2 = (double) SPEC_NO2_values.specPPB;
        spec_struct->no2_temp = (double) SPEC_NO2_values.specTemp;
        spec_struct->no2_hum = (double) SPEC_NO2_values.specRH;
        spec_struct->no2_err = (double)SPEC_NO2_values.error_reason;

        spec_struct->co = (double) SPEC_CO_values.specPPB;
        spec_struct->co_temp = (double) SPEC_CO_values.specTemp;
        spec_struct->co_hum = (double) SPEC_CO_values.specRH;
        spec_struct->co_err = (double)SPEC_CO_values.error_reason;

        spec_struct->o3 = (double) SPEC_O3_values.specPPB;
        spec_struct->o3_temp = (double) SPEC_O3_values.specTemp;
        spec_struct->o3_hum = (double) SPEC_O3_values.specRH;
        spec_struct->o3_err = (double)SPEC_O3_values.error_reason;
    }
    xSemaphoreGive(mutex);
}

static double get_pm_hcho_values(SemaphoreHandle_t mutex,PM_HCHO_TYPES type){
	double res = 0;
	if((mutex != NULL) &&
	(xSemaphoreTake(mutex,portMAX_DELAY) == pdTRUE))
	{
		switch(type){
			case HCHO_T:
				res =  HCHO_val;
				break;
			case PM10_T:
				res = pm10_val;
				break;
			case PM2_5_T:
				res = pm2_5_val;
				break;
			default:
				break;
		}
		xSemaphoreGive(mutex);
	}
	return res;
}

void get_spec_sensors_data(dataPacket_S *spec_struct)
{
    get_spec_values(spec_struct, SPEC_mutex);
}

double get_pm2_5(void)
{
    return get_pm_hcho_values(PMS_mutex,PM2_5_T);
}

double get_pm10(void)
{
    return get_pm_hcho_values(PMS_mutex,PM10_T);
}

double get_HCHO(void)
{
   return get_pm_hcho_values(HCHO_mutex,HCHO_T);
}

void multiplexerSetState(uint8_t state)
{
    if (state)
    {
        HAL_GPIO_WritePin(GPIOA, GPIO_PIN_8, GPIO_PIN_RESET);
    }
    else
    {
        HAL_GPIO_WritePin(GPIOA, GPIO_PIN_8, GPIO_PIN_SET);
    }
}

static void vTimerCallback_SPEC(xTimerHandle pxTimer)
{
    uint8_t data_left_in_dma_buffer = __HAL_DMA_GET_COUNTER(huart3.hdmarx);
    uint8_t dma_data_length = MAX_SPEC_BUF_LEN - data_left_in_dma_buffer;

    xTimerStop( timer_SPEC_ISR, portMAX_DELAY);

    xTaskNotifyAndQuery(uart_sensors_handle, dma_data_length,
                        eSetValueWithOverwrite, NULL);
}

static HAL_StatusTypeDef uart_enable_tx(uint8_t chan)
{
    /* disable both - transmitter and receiver */
    UART_DISABLE_RXTX(&huart3);
    activate_multiplexer_channel(chan);
    /* turn on mux */
    multiplexerSetState(1);
    /* EnableTransmitter(..) returns HAL_OK only */
    HAL_HalfDuplex_EnableTransmitter(&huart3);

    return HAL_OK;
}

static HAL_StatusTypeDef uart_enable_rx(uint8_t chan, uint8_t *buf,
                                        uint32_t buf_len)
{
    HAL_StatusTypeDef err;

    if (!buf || !buf_len)
        return HAL_ERROR;

    /* disable both - transmitter and receiver */
    UART_DISABLE_RXTX(&huart3);
    /* enable RX mux channel */
    activate_multiplexer_channel(chan);
    /* turn on mux */
    multiplexerSetState(1);

    // Ensure the over-run flag is clear in case UART over-run
    __HAL_UART_CLEAR_OREFLAG(&huart3);
    /* enable DMA receiving */
    err = uart_enable_dma_rx(&huart3, buf, buf_len);
    if (err != HAL_OK) {
        /* unblock scheduler switching */
        return err;
    }

    ulTaskNotifyValueClear(NULL, NOTIFY_CLEAR_VAL);
    /* just in case clear IDLE flag if it was set before */
    __HAL_UART_CLEAR_IDLEFLAG(&huart3);
    __HAL_UART_ENABLE_IT(&huart3, UART_IT_IDLE);
    /* EnableReceiver(..) returns HAL_OK only */
    HAL_HalfDuplex_EnableReceiver(&huart3);

    return HAL_OK;
}

static HAL_StatusTypeDef uart_send_data(uint8_t *data, uint32_t len,
                                        uint32_t timeout)
{
    if (!data)
        return HAL_ERROR;

    if (!len)
        return HAL_OK;

    return HAL_UART_Transmit(&huart3, data, len, timeout);
}

static uint32_t uart_wait_response(uint32_t timeout)
{
    uint32_t rx_len;

    rx_len = ulTaskNotifyTake(pdTRUE, (TickType_t)timeout);

    return rx_len;
}

static HAL_StatusTypeDef uart_release()
{
    /* disable both - transmitter and receiver */
    UART_DISABLE_RXTX(&huart3);
    __HAL_UART_DISABLE_IT(&huart3, UART_IT_IDLE);
    /* stop timer in any case. Don't rely on timer callback due to
     * ulTaskNotifyTake(..) can return on timeout */
    xTimerStop(timer_SPEC_ISR, portMAX_DELAY);
    /* stop DMA transfer */
    (void)uart_disable_dma_rx(&huart3);

    multiplexerSetState(0);

    return HAL_OK;
}

static HAL_StatusTypeDef uart_enable_dma_rx(UART_HandleTypeDef *huart,
                                            uint8_t *data, uint16_t size)
{
    DMA_HandleTypeDef *hdma;
    struct dma_base_reg *dmabr;
    /* timeout is a number of tries to read register value */
    int32_t timeout = HAL_DEFAULT_TIMEOUT;

    if (!huart || !data || !size)
        return HAL_ERROR;

    hdma = huart->hdmarx;
    if (!hdma)
        return HAL_ERROR;

    /* disable DMA before configuring */
    __HAL_DMA_DISABLE(hdma);
    /* check if the DMA Stream is effectively disabled */
    while((hdma->Instance->CR & DMA_SxCR_EN) != RESET) {
        if (--timeout < 0)
            return HAL_TIMEOUT;
    }
    // SDS and HCHO sensors transmit data continuously, so there will be such
    // situation when we start measuring at the end of previous packet.
    // We reject such packets, but DMA can enter into overrun state when this happens.
    // In order to exit of DMA overrun state we need to clean following DMA registers.
    /* Clear DBM bit */
    hdma->Instance->CR &= (uint32_t)(~DMA_SxCR_DBM);
    /* Configure DMA Stream data length */
    hdma->Instance->NDTR = size;
    /* Configure DMA Stream source address */
    hdma->Instance->PAR = (uint32_t)&huart->Instance->DR;
    /* Configure DMA Stream destination address */
    hdma->Instance->M0AR = (volatile uint32_t) data;

    /* calculate DMA base and stream number */
    dmabr = (struct dma_base_reg *)hdma->StreamBaseAddress;
    /* clear all interrupt flags */
    dmabr->IFCR = 0x3FU << hdma->StreamIndex;
    /* disable common interrupts */
    hdma->Instance->CR &= ~(DMA_IT_TC | DMA_IT_TE | DMA_IT_DME);
    /* clear overrun flag */
    __HAL_UART_CLEAR_OREFLAG(huart);
    /* enable DMA */
    __HAL_DMA_ENABLE(hdma);
    /* Enable the DMA transfer for the receiver request by setting the DMAR bit
     * in the UART CR3 register */
    SET_BIT(huart->Instance->CR3, USART_CR3_DMAR);

    return HAL_OK;
}

static HAL_StatusTypeDef uart_disable_dma_rx(UART_HandleTypeDef *huart)
{
    DMA_HandleTypeDef *hdma;
    struct dma_base_reg *dmabr;
    /* timeout is a number of tries to read register value */
    int32_t timeout = HAL_DEFAULT_TIMEOUT;

    if (!huart)
        return HAL_ERROR;

    hdma = huart->hdmarx;
    if (!hdma)
        return HAL_ERROR;

    /* Disable all the transfer interrupts */
    hdma->Instance->CR &= ~(DMA_IT_TC | DMA_IT_TE | DMA_IT_DME);
    hdma->Instance->FCR &= ~(DMA_IT_FE);
    /* disable DMA */
    __HAL_DMA_DISABLE(hdma);
    /* check if the DMA Stream is effectively disabled */
    while((hdma->Instance->CR & DMA_SxCR_EN) != RESET) {
        if (--timeout < 0)
            return HAL_TIMEOUT;
    }

    /* calculate DMA base and stream number */
    dmabr = (struct dma_base_reg *)hdma->StreamBaseAddress;
    /* clear all interrupt flags */
    dmabr->IFCR = 0x3FU << hdma->StreamIndex;

    CLEAR_BIT(huart->Instance->CR3, USART_CR3_DMAR);
    uart_end_rx_transfer(huart);

    return HAL_OK;
}

static void uart_end_rx_transfer(UART_HandleTypeDef *huart)
{
    if (!huart)
        return;

    /* Disable RXNE, PE and ERR (Frame error, noise error, overrun error) interrupts */
    CLEAR_BIT(huart->Instance->CR1, (USART_CR1_RXNEIE | USART_CR1_PEIE));
    CLEAR_BIT(huart->Instance->CR3, USART_CR3_EIE);

    /* At end of Rx process, restore huart->RxState to Ready */
    huart->RxState = HAL_UART_STATE_READY;
}

// Not used - it appeared that SPEC can be woke up with data request as well
static HAL_StatusTypeDef uart_spec_wakeup(uint8_t chan)
{
    HAL_StatusTypeDef err;

    err = uart_enable_tx(chan);
    if (err != HAL_OK)
        goto cleanup;

    err = uart_send_data(&spec_wake, 1, WAKEUP_TIMEOUT);

cleanup:
    uart_release();

    return err;
}

static HAL_StatusTypeDef uart_spec_get_data(uint8_t tx, uint8_t rx,
                                            uint32_t *rx_len)
{
    HAL_StatusTypeDef err;

    if (!rx_len)
        return HAL_ERROR;

    err = uart_enable_tx(tx);
    if (err != HAL_OK)
        goto cleanup;

    /* after sending a request for reading SPEC data we need quickly switch
     * to receiving so we need to block scheduler switching */
    vTaskSuspendAll();
    /* ask SPEC for data */
    err = uart_send_data(&spec_get_data, 1, DATA_REQ_TIMEOUT);
    if (err != HAL_OK) {
        /* unblock scheduler switching */
        xTaskResumeAll();
        goto cleanup;
    }

    err = uart_enable_rx(rx, (uint8_t *)uart3IncomingDataBuffer,
                         MAX_SPEC_BUF_LEN);
    if (err != HAL_OK) {
        /* unblock scheduler switching */
        xTaskResumeAll();
        goto cleanup;
    }

    /* we switched to receiving - now we can unblock scheduler switching */
    xTaskResumeAll();
    /* wait for data receiving */
    *rx_len = uart_wait_response(SPEC_RESPONSE_TIME + HAL_DEFAULT_TIMEOUT);

cleanup:
    uart_release();

    return err;
}

static HAL_StatusTypeDef uart_enable_rx_sds_hcho(uint8_t chan, uint8_t *buf,
                                                 uint32_t buf_len)
{
    HAL_StatusTypeDef err;

    if (!buf || !buf_len)
        return HAL_ERROR;

    /* enable RX mux channel */
    activate_multiplexer_channel(chan);
    /* turn on mux */
    multiplexerSetState(1);

    ulTaskNotifyValueClear(NULL, NOTIFY_CLEAR_VAL);
    /* just in case clear IDLE flag if it was set before */
    __HAL_UART_CLEAR_IDLEFLAG(&huart3);
    __HAL_UART_ENABLE_IT(&huart3, UART_IT_IDLE);
    /* EnableReceiver(..) returns HAL_OK only */
    HAL_HalfDuplex_EnableReceiver(&huart3);

    /* enable DMA receiving */
    err = uart_enable_dma_rx(&huart3, (uint8_t *)uart3IncomingDataBuffer,
                             MAX_SPEC_BUF_LEN);

    if (err != HAL_OK) {
        /* unblock scheduler switching */
        return err;
    }
    return HAL_OK;
}

HAL_StatusTypeDef getHCHO(uint8_t rx)
{
    HAL_StatusTypeDef retval = HAL_ERROR;
    HAL_StatusTypeDef err;
    uint32_t rx_len;

    err = uart_enable_rx_sds_hcho(rx, (uint8_t *) uart3IncomingDataBuffer,
                                  MAX_SPEC_BUF_LEN);
    if (err != HAL_OK) {
        uart_release();
        goto cleanup;
    }

    // Pause task until all data received
    rx_len = uart_wait_response(HCHO_RESPONSE_TIME);

    uart_release();

    if (rx_len < MIN_HCHO_BUF_LEN)
        goto cleanup;

    if (uart3IncomingDataBuffer[0] != HCHO_HEADER1 ||
            uart3IncomingDataBuffer[1] != HCHO_HEADER2 ||
            uart3IncomingDataBuffer[2] != HCHO_UNIT_PPB) {
        goto cleanup;
    }

    if (xSemaphoreTake(HCHO_mutex,portMAX_DELAY) == pdTRUE)
    {
        HCHO_val = ((double) ((unsigned int) uart3IncomingDataBuffer[4] << 8 | uart3IncomingDataBuffer[5])) / 1000;
        xSemaphoreGive(HCHO_mutex);

        retval = HAL_OK;
    }

cleanup:
    memset((void*)uart3IncomingDataBuffer, '\0', MAX_SPEC_BUF_LEN);

    return retval;
}

HAL_StatusTypeDef getSDS011(uint8_t rx)
{
    HAL_StatusTypeDef retval = HAL_ERROR;
    HAL_StatusTypeDef err;
    uint32_t rx_len;

    err = uart_enable_rx_sds_hcho(rx, (uint8_t *) uart3IncomingDataBuffer,
                                  MAX_SPEC_BUF_LEN);
    if (err != HAL_OK) {
        uart_release();
        goto cleanup;
    }

    // Pause task until all data received
    rx_len = uart_wait_response(SDS011_RESPONSE_TIME);

    uart_release();

    if (rx_len < MIN_SDS_BUF_LEN)
        goto cleanup;

    // packet format: AA C0 PM25_Low PM25_High PM10_Low PM10_High 0 0 CRC AB
    if (uart3IncomingDataBuffer[0] != SDS_HEADER1 ||
            uart3IncomingDataBuffer[1] != SDS_HEADER2 ||
            uart3IncomingDataBuffer[9] != SDS_TAIL) {
        goto cleanup;
    }

    uint8_t crc_SDS = 0;
    for (int i = 0; i < 6; ++i) {
        crc_SDS += uart3IncomingDataBuffer[i + 2];
    }

    if (crc_SDS != uart3IncomingDataBuffer[8])
        goto cleanup;

    if (xSemaphoreTake(PMS_mutex,portMAX_DELAY) == pdTRUE) {
        pm2_5_val = (double) ((int) uart3IncomingDataBuffer[2] | (int) (uart3IncomingDataBuffer[3] << 8)) / 10;
        pm10_val = (double) ((int) uart3IncomingDataBuffer[4] | (int) (uart3IncomingDataBuffer[5] << 8)) / 10;
        xSemaphoreGive(PMS_mutex);
        retval = HAL_OK;
    }

cleanup:
    memset((void*)uart3IncomingDataBuffer, '\0', MAX_SPEC_BUF_LEN);

    return retval;
}

HAL_StatusTypeDef getSPEC(uint8_t tx, uint8_t rx, struct SPEC_values *SPEC_gas_values,
        const long long int spec_sensor_sn, SPEC_TYPES sensor_type)
{
    HAL_StatusTypeDef retval = HAL_OK;
    HAL_StatusTypeDef err;
    uint32_t rx_len = 0;
    SPEC_gas_values->error_reason = 0;
    // Count DMA overflow errors
    uint32_t dma_error;
    static long spec_error_cntr = 0;

    err = uart_spec_get_data(tx, rx, &rx_len);
    if (err != HAL_OK)
    {
        retval = HAL_ERROR;
        /* failed to read data from SPEC */
        SPEC_gas_values->error_reason = -1;
        goto cleanup;
    }

    dma_error = HAL_DMA_GetError(&huart3_dma_rx);
    // Check received data size
    if (rx_len < MIN_SPEC_BUF_LEN)
    {
        // Should newer be used - we clear overrun flags manually in uart_enable_dma_rx()
        if (dma_error)
        {
            // Re-int DMA
            USART3_DMA_Init();
        }
        retval = HAL_ERROR;
        SPEC_gas_values->error_reason = -2;
        ++spec_error_cntr;
        goto cleanup;
    }

    char *pToNextValue;
    char *firstDeviderPtr;
    const char devider[] = ", ";

    // Check if SPEC sensor eeprom is not corrupted
    firstDeviderPtr = strstr((const char*)uart3IncomingDataBuffer, devider);
    int firstDeviderIndex = (int)(firstDeviderPtr - uart3IncomingDataBuffer);
    uint8_t specEepromCorrupted = firstDeviderIndex >= 0 && firstDeviderIndex < 9; // Means there is no proper sensor ID in packet

    if (firstDeviderPtr == NULL || specEepromCorrupted)
    {
        retval = HAL_ERROR;
        SPEC_gas_values->error_reason = -3; // Corrupted EEPROM (need to re-flash SPEC sensor EEPROM) or empty uart3IncomingDataBuffer
        goto cleanup;
    }

    if(xSemaphoreTake(SPEC_mutex, portMAX_DELAY) == pdTRUE)
    {
        SPEC_gas_values->specSN = strtoull((const char *) uart3IncomingDataBuffer, &pToNextValue, 10);
        xSemaphoreGive(SPEC_mutex);
    }

    if (SPEC_gas_values->specSN == spec_sensor_sn)
    {
        if(xSemaphoreTake(SPEC_mutex, portMAX_DELAY) == pdTRUE)
        {
            SPEC_gas_values->specPPB = strtol(pToNextValue + 2, &pToNextValue, 10);
            SPEC_gas_values->specTemp = strtoul(pToNextValue + 2, &pToNextValue, 10);
            SPEC_gas_values->specRH = strtoul(pToNextValue + 2, &pToNextValue, 10);
            pToNextValue = strstr(pToNextValue + 2, ", ");
            pToNextValue = strstr(pToNextValue + 2, ", ");
            pToNextValue = strstr(pToNextValue + 2, ", ");
            SPEC_gas_values->specDay = strtoul(pToNextValue + 2, &pToNextValue, 10);
            SPEC_gas_values->specHour = strtoul(pToNextValue + 2, &pToNextValue, 10);
            SPEC_gas_values->specMinute = strtoul(pToNextValue + 2, &pToNextValue, 10);
            SPEC_gas_values->specSecond = strtoul(pToNextValue + 2, NULL, 10);
            xSemaphoreGive(SPEC_mutex);
        }
    }
    else
    {
        retval = HAL_ERROR;
        SPEC_gas_values->error_reason = -4; // Got wrong SPEC sensor ID
    }

cleanup:
    memset((void*)uart3IncomingDataBuffer, '\0', MAX_SPEC_BUF_LEN);

    return retval;
}

static void UART_sensors_error_handler()
{
};

void uart_sensors(void * const arg) {

    /* Notify init task that UART sensors task has been started */
    xEventGroupSetBits(eg_task_started, EG_UART_SENSORS_STARTED);

    GPIO_Init();
    USART3_UART_Init();
    USART3_DMA_Init();
    HCHO_mutex = xSemaphoreCreateMutex();
    PMS_mutex = xSemaphoreCreateMutex();
    SPEC_mutex = xSemaphoreCreateMutex();
    timer_SPEC_ISR = xTimerCreate("timer_SPEC_ISR",
                                  (TickType_t) SPEC_NOTIFY_DELAY, pdFALSE,
                                  (void *) 0, vTimerCallback_SPEC);

    while (1) {
        if (getHCHO(MULTIPLEXER_CH0_HCHO_RX) != HAL_OK)
        {
            UART_sensors_error_handler();
        }

        if (getSDS011(MULTIPLEXER_CH1_SDS011_RX) != HAL_OK)
        {
            UART_sensors_error_handler();
        }
        if (getSPEC(MULTIPLEXER_CH2_SO2_TX, MULTIPLEXER_CH3_SO2_RX, &SPEC_SO2_values, SPEC_SO2_SN, SPEC_T_SO2) != HAL_OK)
        {
            UART_sensors_error_handler();
        }
        if (getSPEC(MULTIPLEXER_CH4_NO2_TX, MULTIPLEXER_CH5_NO2_RX, &SPEC_NO2_values, SPEC_NO2_SN, SPEC_T_NO2) != HAL_OK)
        {
            UART_sensors_error_handler();
        }
        if (getSPEC(MULTIPLEXER_CH6_CO_TX, MULTIPLEXER_CH7_CO_RX, &SPEC_CO_values, SPEC_CO_SN, SPEC_T_CO) != HAL_OK)
        {
            UART_sensors_error_handler();
        }
        if (getSPEC(MULTIPLEXER_CH8_O3_TX, MULTIPLEXER_CH9_O3_RX, &SPEC_O3_values, SPEC_O3_SN, SPEC_T_O3) != HAL_OK)
        {
            UART_sensors_error_handler();
        }
    }
}

void HAL_UART_MspInit(UART_HandleTypeDef* huart)
{
    GPIO_InitTypeDef GPIO_InitStruct = {0};
    if(huart->Instance==USART3)
    {
        __HAL_RCC_USART3_CLK_ENABLE();
        __HAL_RCC_DMA1_CLK_ENABLE();
        __HAL_RCC_GPIOD_CLK_ENABLE();
        GPIO_InitStruct.Pin = GPIO_PIN_8;
        GPIO_InitStruct.Mode = GPIO_MODE_AF_OD;
        GPIO_InitStruct.Pull = GPIO_PULLUP;
        GPIO_InitStruct.Speed = GPIO_SPEED_FREQ_VERY_HIGH;
        GPIO_InitStruct.Alternate = GPIO_AF7_USART3;
        HAL_GPIO_Init(GPIOD, &GPIO_InitStruct);
        HAL_NVIC_SetPriority(USART3_IRQn, 5, 0U);
        HAL_NVIC_EnableIRQ(USART3_IRQn);
    }
}
void HAL_UART_MspDeInit(UART_HandleTypeDef* huart)
{
    if(huart->Instance==USART3)
    {
        __HAL_RCC_USART3_CLK_DISABLE();
        HAL_GPIO_DeInit(GPIOD, GPIO_PIN_8);
        HAL_NVIC_DisableIRQ(USART3_IRQn);
    }
}
void UART_SENSORS_IRQHandler(UART_HandleTypeDef *huart) {
    if (USART3 == huart->Instance)
    {
        if(uart_sensors_handle == NULL)
        {
            taskDISABLE_INTERRUPTS();
            for( ;; );
        }
        // If UART is IDLE - no data at UART, so need to reset timer
        // Only after timer will occur we will count packet as received
        if(__HAL_UART_GET_FLAG(huart, UART_FLAG_IDLE))
        {
            __HAL_UART_CLEAR_IDLEFLAG(huart);
            BaseType_t uart_rx_task_woken = pdFALSE;
            xTimerResetFromISR(timer_SPEC_ISR, &uart_rx_task_woken);
            portYIELD_FROM_ISR(uart_rx_task_woken);
        }
    }
}
