anton-mir/airc-device/inc/tasks_def.h

#ifndef TASKS_DEF_H
#define TASKS_DEF_H

#define INIT_TASK_PRIO                      (tskIDLE_PRIORITY)
#define INIT_TASK_STACK_SIZE                (configMINIMAL_STACK_SIZE * 2)

#define ETHIF_IN_TASK_PRIO                  (tskIDLE_PRIORITY + 3)
#define ETHIF_IN_TASK_STACK_SIZE            (configMINIMAL_STACK_SIZE * 4)

#define LINK_STATE_TASK_PRIO                (tskIDLE_PRIORITY + 2)
#define LINK_STATE_TASK_STACK_SIZE          (configMINIMAL_STACK_SIZE * 2)

#define DHCP_FSM_TASK_PRIO                  (tskIDLE_PRIORITY + 1)
#define DHCP_FSM_TASK_STACK_SIZE            (configMINIMAL_STACK_SIZE * 2)

#define ECHO_SERVER_TASK_PRIO               (tskIDLE_PRIORITY + 1)
#define ECHO_SERVER_TASK_STACK_SIZE         (configMINIMAL_STACK_SIZE * 2)

#define ESP8266_WIFI_TASK_PRIO              (tskIDLE_PRIORITY + 1)
#define ESP8266_WIFI_TASK_STACK_SIZE        (configMINIMAL_STACK_SIZE * 6)

#define ESP8266_RX_TASK_PRIO                (tskIDLE_PRIORITY + 1)
#define ESP8266_RX_TASK_STACK_SIZE          (configMINIMAL_STACK_SIZE * 4)

#define ANALOG_TEMP_TASK_PRIO               (tskIDLE_PRIORITY + 1)
#define ANALOG_TEMP_TASK_STACK_SIZE         (configMINIMAL_STACK_SIZE * 3)

#define ETH_SERVER_TASK_PRIO                (tskIDLE_PRIORITY + 1)
#define ETH_SERVER_TASK_STACK_SIZE          (configMINIMAL_STACK_SIZE * 6)

#define ETH_SENDER_TASK_PRIO                (tskIDLE_PRIORITY + 1)
#define ETH_SENDER_TASK_STACK_SIZE          (configMINIMAL_STACK_SIZE * 6)

#define DATA_COLLECTOR_PRIO                 (tskIDLE_PRIORITY + 1)
#define DATA_COLLECTOR_STACK_SIZE           (configMINIMAL_STACK_SIZE * 6)

#define REED_SWITCH_PRIO                    (tskIDLE_PRIORITY + 1)
#define REED_SWITCH_STACK_SIZE              (configMINIMAL_STACK_SIZE * 2)

#define UART_SENSORS_TASK_PRIO              (tskIDLE_PRIORITY + 1)
#define UART_SENSORS_TASK_STACK_SIZE        (configMINIMAL_STACK_SIZE * 2)

#define I2C_BME280_SENSOR_TASK_PRIO         (tskIDLE_PRIORITY + 1)
#define I2C_BME280_SENSOR_TASK_STACK_SIZE   (configMINIMAL_STACK_SIZE * 2)

#define DISPLAY_DATA_TASK_PRIO         (tskIDLE_PRIORITY + 1)
#define DISPLAY_DATA_TASK_STACK_SIZE   (configMINIMAL_STACK_SIZE * 3)
#endif /* TASKS_DEF_H */
