anton-mir/airc-device/inc/uart_sensors.h

#ifndef AIRC_DEVICE_UART_SENSORS_H
#define AIRC_DEVICE_UART_SENSORS_H

#include "stm32f4xx_hal.h"
#include "data_structure.h"

#define  MAX_SPEC_BUF_LEN 100
#define  MIN_SPEC_BUF_LEN 44
#define MIN_SDS_BUF_LEN 10
#define MIN_HCHO_BUF_LEN 9

#define MULTIPLEXER_CH0_HCHO_RX 0
#define MULTIPLEXER_CH1_SDS011_RX 1
#define MULTIPLEXER_CH2_SO2_TX 2
#define MULTIPLEXER_CH3_SO2_RX 3
#define MULTIPLEXER_CH4_NO2_TX 4
#define MULTIPLEXER_CH5_NO2_RX 5
#define MULTIPLEXER_CH6_CO_TX  6
#define MULTIPLEXER_CH7_CO_RX  7
#define MULTIPLEXER_CH8_O3_TX  8
#define MULTIPLEXER_CH9_O3_RX  9

#define SPEC_RESPONSE_TIME 1000
#define SDS011_RESPONSE_TIME 1100
#define HCHO_RESPONSE_TIME 1000

#define SPEC_NOTIFY_DELAY 65

#define SDS_HEADER1 0xAA
#define SDS_HEADER2 0xC0
#define SDS_TAIL 0xAB
#define HCHO_HEADER1 0XFF //255
#define HCHO_HEADER2 0X17 //23
#define HCHO_UNIT_PPB 0X04

UART_HandleTypeDef huart3;
DMA_HandleTypeDef huart3_dma_rx;

void UART_SENSORS_IRQHandler(UART_HandleTypeDef *huart);

void uart_sensors(void * arg);

struct SPEC_values
{
    unsigned long long int specSN;
    long long specPPB;
    unsigned long int specTemp, specRH, specDay, specHour, specMinute, specSecond;
    int8_t error_reason;
};

void get_spec_sensors_data(dataPacket_S *spec_struct);
double get_pm2_5(void);
double get_pm10(void);
double get_HCHO(void);

#endif //AIRC_DEVICE_UART_SENSORS_H
