anton-mir/airc-device/src/eth_server.c

#include <stdint.h>
#include "FreeRTOS.h"
#include "semphr.h"
#include "task.h"
#include "main.h"
#include "lwip/opt.h"
#include "lwip/sys.h"
#include "lwip/sockets.h"
#include "lwip/mem.h"
#include "eth_server.h"


#define CHECK_CONNECTION_BUF_SIZE       (32)

static int clients[MAX_CLIENTS];
static uint8_t check_conn_buf[CHECK_CONNECTION_BUF_SIZE];
SemaphoreHandle_t clients_mut;

uint32_t sender_ethernet (void *data, uint32_t size){
    uint32_t err=0;
    uint32_t result=ETH_STATUS_SEND_OK;
    for (int i = 0; i < MAX_CLIENTS; i++)
    {
        if (clients[i] != 0)
        {
            xSemaphoreTake(clients_mut, portMAX_DELAY);
            err=lwip_write(clients[i], data, size);
            xSemaphoreGive(clients_mut);
            if(err!=size)
            {
                result|=1<<i;
            }
        }
    }
    return result;
}

static int add_client(int new_clientfd)
{
    int retval = -EINVAL;
    for (int i = 0; i < MAX_CLIENTS; i++)
    {
        if (clients[i] == 0)
        {
            xSemaphoreTake(clients_mut, portMAX_DELAY);
            clients[i] = new_clientfd;
            xSemaphoreGive(clients_mut);
            retval = 0;
            break;
        }
    }
    return retval;
}

void eth_server(void * const arg)
{
    int listenfd;
    fd_set readfds;
    int maxfd;
    int clientfd;
    int err;
    int read_len;
    struct sockaddr_in server_addr;
    struct sockaddr_storage client_addr;
    socklen_t client_len;

    memset(&server_addr, 0, sizeof(server_addr));

    clients_mut = xSemaphoreCreateMutex();
    if (!clients_mut)
    {
        LWIP_ASSERT("server(): cannot create mutex", 0);
        return;
    }
    xEventGroupWaitBits(
                eg_task_started,
                (EG_INIT_STARTED | EG_ETHERIF_IN_STARTED | EG_LINK_STATE_STARTED | EG_DHCP_FSM_STARTED),
                pdFALSE,
                pdTRUE,
                portMAX_DELAY);
    /* Notify init task that server task has been started */
    xEventGroupSetBits(eg_task_started, EG_ETH_SERVER_STARTED);

    listenfd = lwip_socket(AF_INET, SOCK_STREAM, 0);
    LWIP_ASSERT("server(): socket create failed", listenfd >= 0);

    server_addr.sin_family = AF_INET;
    server_addr.sin_addr.s_addr = PP_HTONL(INADDR_ANY);
    server_addr.sin_port = lwip_htons(SERVER_PORT);

    err = lwip_bind(listenfd, (struct sockaddr *)&server_addr, sizeof(server_addr));
    if (err < 0)
    {
        LWIP_ASSERT("server(): socket bind failed", 0);
    }

    err = lwip_listen(listenfd, MAX_CLIENTS);
    if (err < 0)
    {
        LWIP_ASSERT("server(): socket listen failed", 0);
    }

    for (;;)
    {
        FD_ZERO(&readfds);
        FD_SET(listenfd, &readfds);
        maxfd = listenfd;

        for (int i = 0; i < MAX_CLIENTS; i++)
        {
            clientfd = clients[i];

            if (clientfd > 0)
            {
                FD_SET(clientfd, &readfds);
            }

            if (clientfd > maxfd)
            {
                maxfd = clientfd;
            }
        }

        err = select((maxfd + 1), &readfds, NULL, NULL, NULL);
        if (err < 0)
            continue;

        /* check for new client */
        if (FD_ISSET(listenfd, &readfds))
        {
            clientfd = lwip_accept(
                    listenfd,
                    (struct sockaddr *)&client_addr,
                    &client_len);
            if (clientfd < 0)
                continue;

            err = add_client(clientfd);
            /* if err < 0 - no free slots for new connection
             * client is rejected */
        }

        /* check for already connected clients */
        for (int i = 0; i < MAX_CLIENTS; i++)
        {
            clientfd = clients[i];

            if (clientfd > 0 && FD_ISSET(clientfd, &readfds))
            {
                read_len = lwip_read(
                        clientfd,
                        check_conn_buf,
                        CHECK_CONNECTION_BUF_SIZE);

                if (read_len <= 0)
                {
                    /* client disconnected or error - drop this connection */
                    lwip_close(clientfd);
                    xSemaphoreTake(clients_mut, portMAX_DELAY);
                    clients[i] = 0;
                    xSemaphoreGive(clients_mut);
                }
            }
        }
    }
}
