anton-mir/airc-device/inc/data_collector.h

#ifndef DATA_COLLECTOR_H
#define DATA_COLLECTOR_H
#include "data_structure.h"
/*
    DATA_PACKET_BUFFER_SIZE defines how frequent the fans will be turn on/off.
    Because we add one packet to the buffer every second until it`s get full.
*/

void data_collector(void *pvParameters);

#endif
