anton-mir/airc-device/src/number_helper.c

#include <string.h>
#include "number_helper.h"

static const double rounders[MAX_PRECISION + 1] =
{
	0.5,				// 0
	0.05,				// 1
	0.005,				// 2
	0.0005,				// 3
	0.00005,			// 4
	0.000005,			// 5
	0.0000005,			// 6
	0.00000005,			// 7
	0.000000005,		// 8
	0.0000000005,		// 9
	0.00000000005		// 10
};

char *ftoa(double f, char *buf, int precision)
{
	char * ptr = buf;
	char * p = ptr;
	char * p1;
	char c;
	long intPart;

	// check precision bounds
	if (precision > MAX_PRECISION)
		precision = MAX_PRECISION;

	// sign stuff
	if (f < 0)
	{
		f = -f;
		*ptr++ = '-';
	}

	if (precision < 0)  // negative precision == automatic precision guess
	{
		if (f < 1.0) precision = 6;
		else if (f < 10.0) precision = 5;
		else if (f < 100.0) precision = 4;
		else if (f < 1000.0) precision = 3;
		else if (f < 10000.0) precision = 2;
		else if (f < 100000.0) precision = 1;
		else precision = 0;
	}

	// round value according the precision
	if (precision)
		f += rounders[precision];

	// integer part...
	intPart = f;
	f -= intPart;

	if (!intPart)
		*ptr++ = '0';
	else
	{
		// save start pointer
		p = ptr;

		// convert (reverse order)
		while (intPart)
		{
			*p++ = '0' + intPart % 10;
			intPart /= 10;
		}

		// save end pos
		p1 = p;

		// reverse result
		while (p > ptr)
		{
			c = *--p;
			*p = *ptr;
			*ptr++ = c;
		}

		// restore end pos
		ptr = p1;
	}

	// decimal part
	if (precision)
	{
		// place decimal point
		*ptr++ = '.';

		// convert
		while (precision--)
		{
			f *= 10.0;
			c = f;
			*ptr++ = '0' + c;
			f -= c;
		}
	}

	// terminating zero
	*ptr = 0;

	return buf;
}

double atof(char *s)
{
    double rez = 0, fact = 1;
    if (*s == '-'){
        s++;
        fact = -1;
    };
    for (int point_seen = 0; *s; s++){
        if (*s == '.'){
            point_seen = 1;
            continue;
        };
        int d = *s - '0';
        if (d >= 0 && d <= 9){
            if (point_seen) fact /= 10.0f;
            rez = rez * 10.0f + (float)d;
        };
    };
    return rez * fact;
};

char *ulltoa(unsigned long long int x, char *buf)
{
    int i = ULL_STRING_LENGTH - 2;

    memset(buf, '\0', ULL_STRING_LENGTH);

	if (x == 0)
	{
		buf[i] = '0';
		return buf + i;
	}

    while (x != 0) { 
		buf[i--] = (x % 10) + '0';
        x /= 10;
    }

    return buf + i + 1; 
}

unsigned long long int atoull(char *buf)
{
	unsigned long long int x = 0;
	size_t length = strlen(buf);
	
	for (size_t i = 0; i < length; i++)
	{
		x *= 10;
		x += buf[i] - '0';
	}
	
	return x;
}
