anton-mir/airc-device/inc/flash_SST25VF016B.h

#ifndef FLASH_H_SST25VF016B 
#define FLASH_H_SST25VF016B 

#include "stm32f4xx_hal.h"

void Flash_Init(void);

void SendByte(uint8_t);
uint8_t ReceiveByte(void);

void ReadDataArrayFromAddress(uint32_t,uint8_t*,uint32_t);
void WriteDataArrayWithAAI(uint32_t,uint8_t*,uint32_t);
void WriteToStatusRegister(uint8_t);
uint8_t readStatusRegister(void);
void Clear(void);
void ClearSector (uint32_t address);
void disableFlash(void);
void enableFlash(void);

#endif
