anton-mir/airc-device/(commit log)

2020-06-05 Fix issue with socket descriptors
2020-06-08 Workaround: rand() causes Hard Fault
    [main.c]
2020-06-13 Added function for reading temperature from an analog sensor
2020-06-13 Fixed xTaskCreate for analog temperature
    [main.c]
2020-06-17 Set UART3
2020-06-22 Add task for CO sensor
2020-06-24 Add CO sensor implementation
2020-07-08 Changed receiving data from UART
2020-07-11 Added status for task and fix error
    [main.c, main.h]
2020-07-11 Fixed bug in main.h
    [main.h]
2020-07-20 Extra lines removed. Added get_analog_temp function for analog sensor.
2020-07-20 Try to get uart data
2020-07-22 Set pull up, received uart data
2020-07-22 Moved msp init to uart_sensors.c
2020-07-22 Added structure for data from sensors
2020-07-27 Corrected non-blocking uart transmit
    [uart_sensors.c]
2020-07-28 Changed semaphore to notification for uart transmit
2020-08-03 Add all spec sensors implementation
2020-08-03 Add getters for spec sensors
2020-08-13 add change_led() and button interrups
2020-08-15 Improvements i2c
2020-08-16 Set DMA
2020-08-16 Led functions extention
2020-08-17 changed code that rests LEDs
2020-08-18 refactored code that resets leds
    [main.c]
2020-08-20 Fix wifi branch
    Remove echo_server
    [main.c, main.h]
2020-08-22 Improved uart sensors data receive
2020-08-23 Corrected uart sensors data receive
    [uart_sensors.c]
2020-08-24 Fix page loading & update configuration page
    [esp8266_wifi.c, esp8266_wifi.h, http_helper.c, http_helper.h, main.c, main.h, tasks_def.h]
2020-08-25 Reed Switch fix Pull state and minor changes
    [leds.c, leds.h, main.c, main.h]
2020-08-25 SPEC SO2 sensor parsing - Data from SO2 parsed - Add multiplexer on/off function - Data from SPEC sensor transferred to data_collector
2020-08-26 Add new implementation for all spec sensors
2020-08-26 Update access to settings page with button
2020-08-27 Added hal SPI.
2020-08-27 Updated cmake for spi.
2020-08-27 SPEC sensors got data
2020-08-27 Updated and fixed error.
    [config_board.c, config_board.h, flash_SST25VF016B.h, main.c]
2020-08-28 Corrected interaction with sensors
    [uart_sensors.c]
2020-08-28 Added sensor serial numbers to boxConfig.
2020-08-28 Try to fix UART echo
    [uart_sensors.c]
2020-09-02 I2C address shift add
2020-09-02 Try to implement UART receive without delay
2020-09-03 Implemented UART receive without delay
2020-09-07 Update for device config
2020-09-13 Update with debug UART
2020-09-15 Change debug uart
2020-09-15 created new branch for correct merging of implementation SDS011 and HCHO sensors
    [data_collector.c, uart_sensors.c, uart_sensors.h]
2020-09-16 Add HAL_UART_DMAStop() and uart_sensors refactoring
2020-09-17 Remove debug uart
2020-09-17 Fix bug with NVIC interrupt
    [main.c, uart_sensors.c]
2020-09-18 Add UART3 disable while not using
2020-09-22 Added files for correct work of I2C
2020-09-22 Added header file of BME280 sensor and added tasks for correct work in FreeRTOS
    [bmp280.h, main.h, tasks_def.h]
2020-09-22 Added .c file with implementation of BME280 sensor, added all necessary changes in CMake and main.c for correct work
    [bmp280.c, main.c]
2020-09-23 Some I2C fixes
2020-09-24 I2C fixes
2020-09-24 I2C problem fixed
2020-09-24 Change back wrong modifications
    [bmp280.c, main.c]
2020-09-24 CCS811 I2C sensor works
2020-09-27 Corrected all start task notifications
    [data_collector.c, eth_sender.c, eth_server.c, leds.c, main.c, main.h, uart_sensors.c]
2020-09-27 Fixed error with cfg.
    [config_board.c, config_board.h]
2020-09-28 add task taht displays sensors data on the lcd display
2020-09-29 ccs811 sensor code rebased on master
2020-10-12 Implemented getters and changed data_collector for correct work
    [bmp280.c, data_collector.c]
2020-10-13 Fix for task stack sizes and buffer for result data initialization
    [data_collector.c, tasks_def.h]
2020-10-16 changed getters to correct implementation
    [bmp280.c]
2020-10-22 add bme280 temperature getter and remove some duplicate code in getters
2020-10-27 Fix wrong bme data float->double conversion
    [bmp280.c]
2020-10-28 Fix led blinking whith config mode
    [leds.c]
2020-10-28 Fix led blinking again
    [leds.c]
2020-10-31 Print IP to ESP log
2020-11-03 SPEC error codes and hum, temp
    Sending data structure will now have
    SPEC error code if SPEC data read error happned.
    Also add humidity and temperature from SPEC sensors to
    final data structure.
    [data_collector.c, data_collector.h, data_structure.h, uart_sensors.c, uart_sensors.h]
2020-11-04 reimplement display_data task, now it doesn't depend on the order of data_packet elements
    [display_data.c]
2020-11-08 Fix SPEC PPB value may be signed
    [data_collector.c, uart_sensors.c, uart_sensors.h]
2020-11-23 Fix sending data to cloud spec errors
    [data_collector.c, display_data.c, uart_sensors.c]
2020-11-23 Add msg counter to config, fix display queue
    [config_board.h, data_collector.c, data_structure.h, display_data.c, tasks_def.h, uart_sensors.c]
2020-11-23 Fix display add packet counter to it
    [data_collector.c, display_data.c, tasks_def.h]
2020-11-24 Add spec error code to display
    [display_data.c]
2020-11-24 Fix SPEC error at display
    [data_collector.c]
2020-11-29 Try to fix SPEC problem
    [uart_sensors.c, uart_sensors.h]
2020-12-11 Successfull debug session with Roman * SPECs work fixed * need to fix also SDS and HCHO
    [uart_sensors.c, uart_sensors.h]
2020-12-16 Check dma_error and re-init DMA
2020-12-19 Add Roman's patch to clear DMA registers
    Now finally problem with DMA overrun solved
    [uart_sensors.c, uart_sensors.h]
2020-12-19 Add documentation for sensors
2020-12-19 Add AirC enclosure drawings
2020-12-19 DSDK tool for SPEC sensors diagnostic
2020-12-19 Add specification for AirC Device
    [AirC sensors and pinout specification.ods]
2024-10-15 Add flash config for airc_dev
    [gdb.cfg]
2024-10-21 Fixes and improvements - while(1) removed in sensor init - improve openocd flashing - add VSCode debug config
    [gdb.cfg]
2024-11-03 Clean repo and update readme
    [gdb.cfg]
